carrola1/NFC_Toy/Hardware/Pics/IMG_4041.JPG

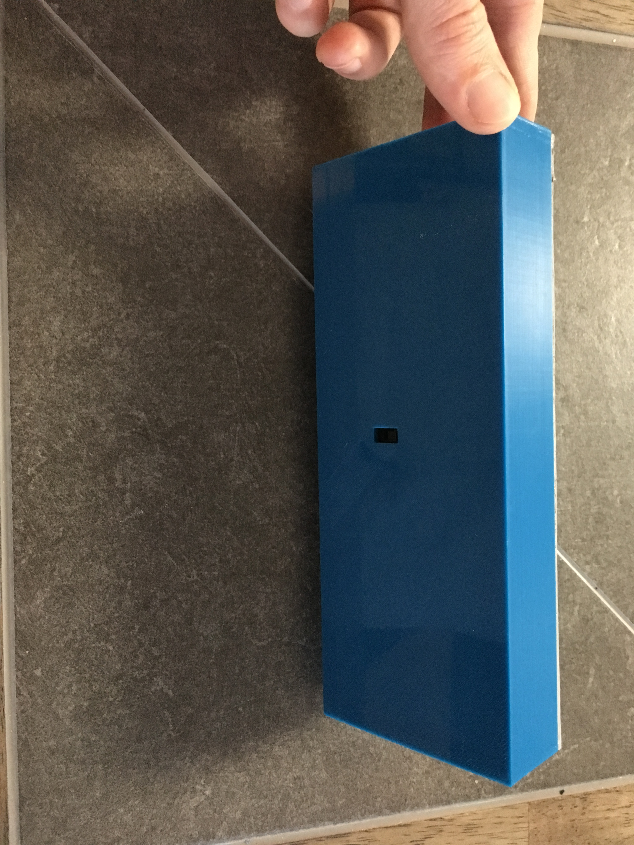
Hardware/Pics/IMG_4041.JPG
