carrola1/NFC_Toy/Hardware/Pics/NFC_TOY.PNG

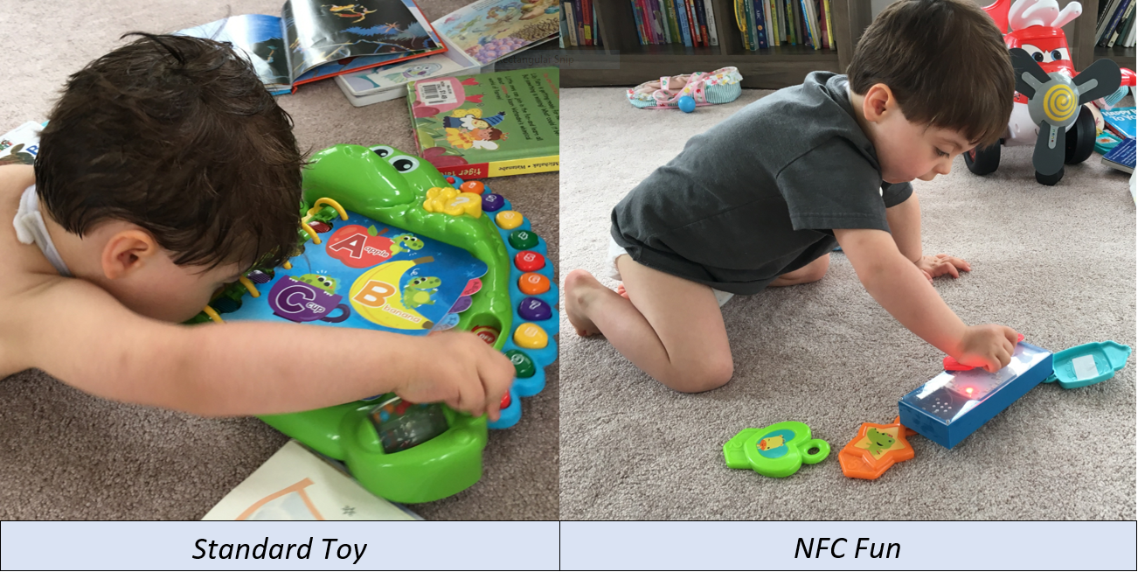
Hardware/Pics/NFC_TOY.PNG
