carrola1/NFC_Toy/Hardware/Adafruit NFC Breakout/Antenna Dimensions.png

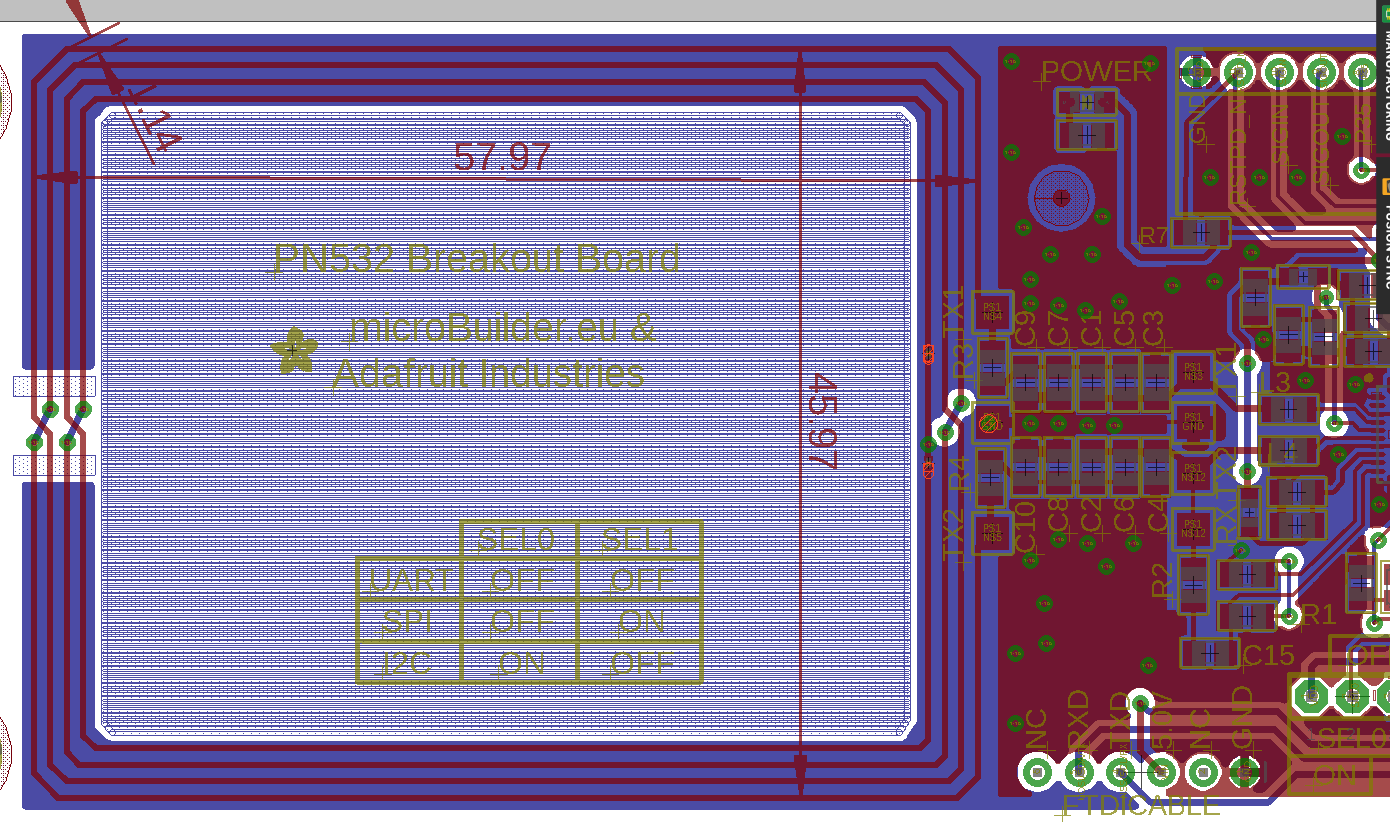
Hardware/Adafruit NFC Breakout/Antenna Dimensions.png
