carrola1/NFC_Toy/Hardware/Pics/IMG_4040.JPG

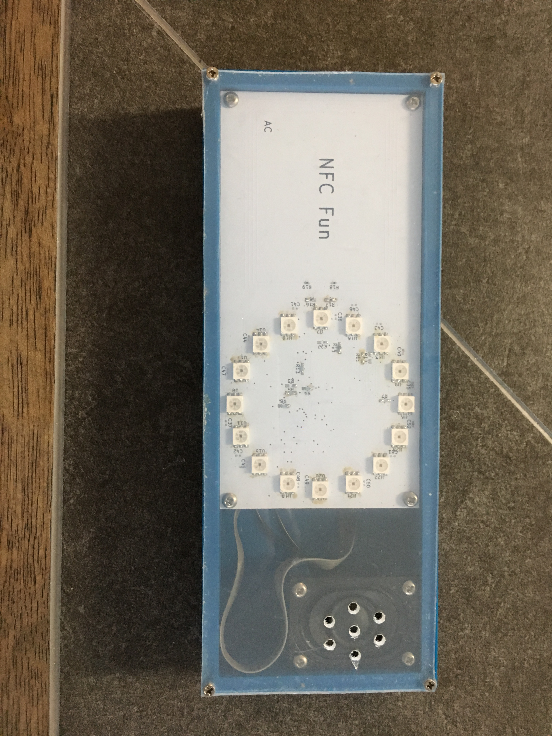
Hardware/Pics/IMG_4040.JPG
