carrola1/NFC_Toy/Hardware/Pics/IMG_4042.JPG

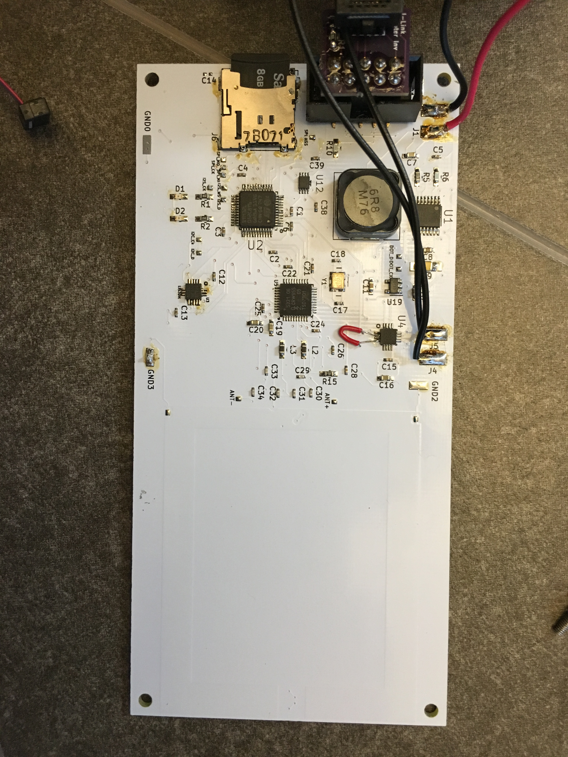
Hardware/Pics/IMG_4042.JPG
