carrola1/NFC_Toy/Hardware/Pics/IMG_4043.JPG

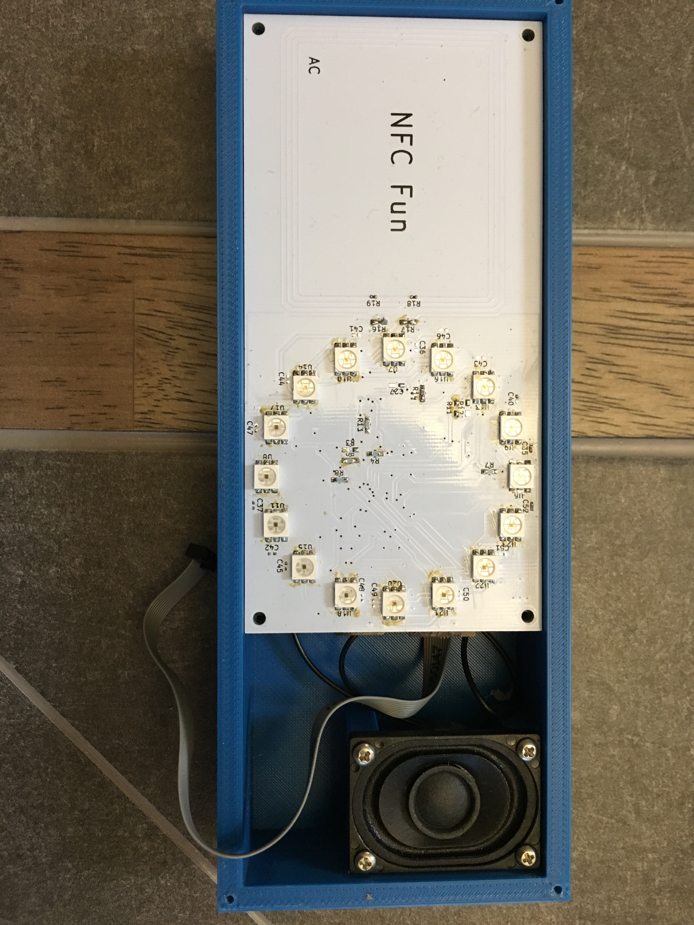
Hardware/Pics/IMG_4043.JPG
