carrola1/NFC_Toy/Hardware/NFC Toy BOM.xlsx

Part # | Manufacturer | Description | Order Qty | Cost | Package | Notes | Footprint Checked | On Order
STM32L052C8T6 | STMicro | Cortex-M0+, 64kB flash, 64kB RAM | 1 | $3.77 | 48-LQFP | 3xSPI/I2S. 1 DAC. | Yes | Yes
MAX98357A | Maxim | I2S Class D audio amp | 1 | $2.22 | 16-TQFN | Arduino library available. This package available on Mouser. | Yes | Yes
PN5321 | NXP | NFC controller | 1 | $11.99 | 40-VFQFN | Widely used. Arduino library available. | Yes | Yes
LIS3DH | STMicro | 3-axis accelerometer | 1 | $1.53 | 16-LGA | Used for space toy. I2C or SPI. | Yes | Yes
5031821852 | Molex | Micro SD connector | 1 | $2.33 | SMD |  | Yes | Yes
TPS61032 | TI | 5V boost converter | 1 | $2.76 | 16-TSSOP | Used on adafruit PowerBoost 1000 | Yes | Yes
MIC5225-3.3 | Microchip | Linear regulator | 1 | $0.41 | SOT-23-5 |  | Yes | Yes
2343 | Adafruit | RGB DotStar LED | 2 | $9.00 | 5x5 mm | Price is for 10 pack | Yes | Yes
3020-10-0300-00 | CNC Tech | SWD header | 1 | $1.29 | SMD | For use with Segger J-Link | Yes | Yes
8.08.91 J-LINK EDU MINI | Segger | J-Link Debugger | 1 | $20.35 | N/A | On digikey or adafruit | N/A | Yes
H3CCH-1006G | Assmann | SWD cable | 1 | $1.10 | N/A | For J-Link | N/A | Yes
LTST-C191KGKT | Lite-On | Green LED, 2V, 20mA | 1 | $0.29 | 0603 |  | N/A | Yes
LTST-C191KFKT | Lite-On | Orange LED, 2V, 20mA | 1 | $0.29 | 0603 |  | N/A | Yes
CDRH124NP-6R8MC | Sumida | Inductor, 6.8uH | 1 | $1.41 | 12x12mm |  | Yes | Yes
7M-27.120MAAJ-T | TXC | 27.12MHz oscillator | 1 | $1.00 | 4-SMD |  | Yes | Yes
SN74LVC2T45 | TI | Dual Level Translator | 1 | $0.61 | 8-VSSOP | For dotstar | Yes | Yes
GCM155R71C104KA55D (https://www.digikey.com/product-detail/en/murata-electronics-north-america/GCM155R71C104KA55D/490-4759-1-ND/1641678) | Murata | Capacitor - 0.1uF | 20 | $0.80 | 0402 |  |  | Yes
GRM188R60J106ME47D (https://www.digikey.com/product-detail/en/murata-electronics-north-america/GRM188R60J106ME47D/490-3896-1-ND/965938) | Murata | Capacitor - 10uF | 10 | $1.20 | 0603 |  |  | Yes
CL10A225KP8NNNC (https://www.digikey.com/product-detail/en/samsung-electro-mechanics/CL10A225KP8NNNC/1276-1085-1-ND/3889171) | Samsung | Capacitor - 2.2uF | 10 | $0.87 | 0603 |  |  | Yes
CC0603ZRY5V6BB105 (https://www.digikey.com/product-detail/en/yageo/CC0603ZRY5V6BB105/311-1357-1-ND/2103141) | Yageo | Capacitor - 1uF | 10 | $0.62 | 0603 |  |  | Yes
F950G227MAAAQ2 (https://www.digikey.com/product-detail/en/avx-corporation/F950G227MAAAQ2/478-8368-1-ND/4005666) |  | Capacitor (Tantalum) - 220uF | 2 | $2.12 | 1206 |  |  | Yes
885012005010 (https://www.digikey.com/product-detail/en/wurth-electronics-inc/885012005010/732-7428-1-ND/5454055) | Wurth | Capacitor - 33pF | 10 | $1.00 | 0402 |  |  | Yes
GRM155R60J102KA01D (https://www.digikey.com/product-detail/en/murata-electronics-north-america/GRM155R60J102KA01D/490-6285-1-ND/3845482) | Murata | Capacitor - 1000pF | 10 | $0.30 | 0402 |  |  | Yes
885012005015 | Wurth | Capacitor - 220pF | 10 | $1.00 | 0402 |  |  | Yes
885012005009 | Wurth | Capacitor - 22pF | 10 | $1.00 | 0402 |  |  | Yes
885012005013 | Wurth | Capacitor - 100pF | 10 | $1.00 | 0402 |  |  | Yes
MLJ1608WR56JT000 (https://www.digikey.com/product-detail/en/tdk-corporation/MLJ1608WR56JT000/445-174193-1-ND/5813302) | TDK | Inductor - 560 nH | 4 | $1.20 | 0603 |  |  | Yes
RMCF0603FT121R (https://www.digikey.com/product-detail/en/stackpole-electronics-inc/RMCF0603FT121R/RMCF0603FT121RCT-ND/1942968) | Stackpole | Resistor - 121 ohm | 10 | $0.15 | 0603 |  |  | Yes
MCT06030C1002FP500 (https://www.digikey.com/product-detail/en/vishay-beyschlag/MCT06030C1002FP500/MCT0603-10.0K-CFCT-ND/2607933) | Yageo | Resistor - 10k ohm | 20 | $0.30 | 0603 |  |  | Yes
RC0603FR-0730KL | Yageo | Resistor - 30k ohm | 10 | $0.15 | 0603 |  |  | Yes
RC0603FR-071KL (https://www.digikey.com/product-detail/en/yageo/RC0603FR-071KL/311-1.00KHRCT-ND/729790) | Yageo | Resistor - 1k ohm | 10 | $0.15 | 0603 |  |  | Yes
RC0603FR-071K5L (https://www.digikey.com/product-detail/en/yageo/RC0603FR-071K5L/311-1.50KHRCT-ND/729811) | Yageo | Resistor - 1.5k ohm | 10 | $0.15 | 0603 |  |  | Yes
RC0603FR-071K6L (https://www.digikey.com/product-detail/en/yageo/RC0603FR-071K6L/311-1.60KHRCT-ND/729815) | Yageo | Resistor - 1.6k ohm | 10 | $0.15 | 0603 |  |  | Yes
RR0816P-104-D (https://www.digikey.com/product-detail/en/susumu/RR0816P-104-D/RR08P100KDCT-ND/432772) | Susumu | Resistor - 100k ohm | 10 | $0.98 | 0603 |  |  | Yes
RC1005J000CS (https://www.digikey.com/product-detail/en/samsung-electro-mechanics/RC1005J000CS/1276-3480-1-ND/3903583) | Samsung | Resistor - 0 ohm | 10 |  | 0402 |  |  | Yes
SFH11-PBPC-D05-ST-BK (https://www.digikey.com/product-detail/en/sullins-connector-solutions/SFH11-PBPC-D05-ST-BK/S9194-ND/1990087) |  | 10-pin plug - 0.1" | 1 | $0.66 | Through Hole
20021121-00010C4LF (https://www.digikey.com/product-detail/en/amphenol-fci/20021121-00010C4LF/609-3695-1-ND/2209147) | Amphenol | 10-pin header - .005" | 1 | $0.84 | SMT
 |  |  | Total | $73.49
