carrola1/NFC_Toy/Hardware/Enclosure/NFC Toy Base.stl

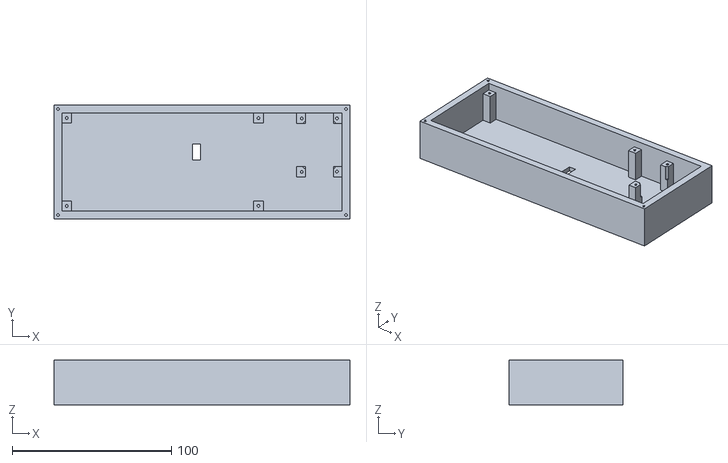
[picture p7: CAD file, 2019-02-22]
Hardware/Enclosure/NFC Toy Base.stl
186.0 x 71.6 x 28.0
