carrola1/NFC_Toy/(list of files, cad)

Other CAD files:
Hardware/Enclosure/NFC Toy Base (old).stl
