carrola1/NFC_Toy/Hardware/NFC_Toy_KiCAD/JLink_Adpater/JLink_Adpater.kicad_pcb

## KiCad design Hardware/NFC_Toy_KiCAD/JLink_Adpater/JLink_Adpater.kicad_pcb (2018-05-30)

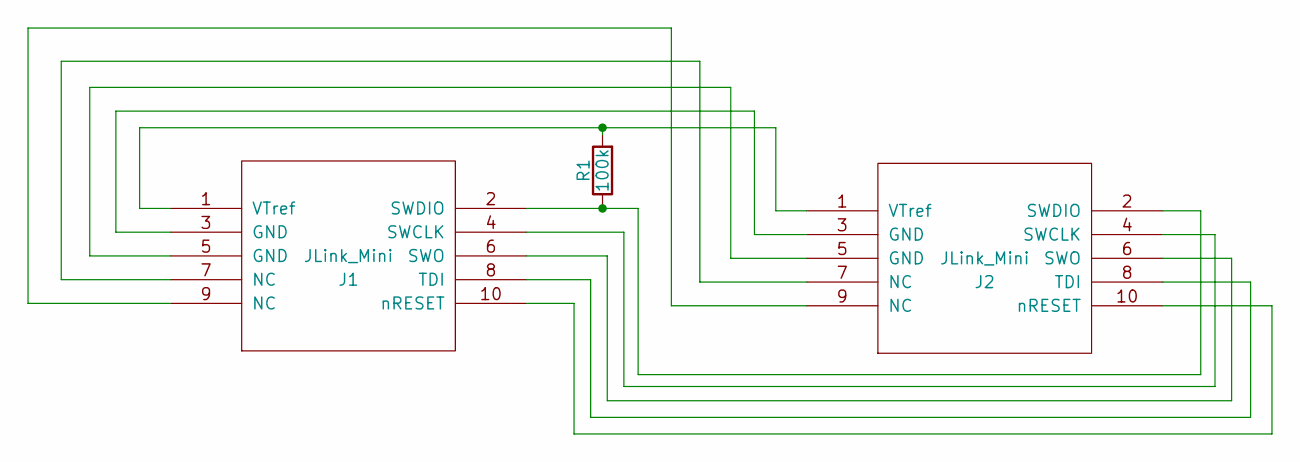
[picture p8: schematic JLink_Adpater.sch]

Parts:
J1: JLink_Mini; JLink_Mini_0p05_inverted
J2: JLink_Mini; J-Link_0p1in_inverted
R1: 100k; R_0603_HandSoldering

Connections:
unnamed: J1.1 (VTref), J2.1 (VTref), R1.2
unnamed: J1.2 (SWDIO), J2.2 (SWDIO), R1.1
unnamed: J1.3 (GND), J2.3 (GND)
unnamed: J1.4 (SWCLK), J2.4 (SWCLK)
unnamed: J1.5 (GND), J2.5 (GND)
unnamed: J1.6 (SWO), J2.6 (SWO)
unnamed: J1.7 (NC), J2.7 (NC)
unnamed: J1.8 (TDI), J2.8 (TDI)
unnamed: J1.9 (NC), J2.9 (NC)
unnamed: J1.10 (nRESET), J2.10 (nRESET)

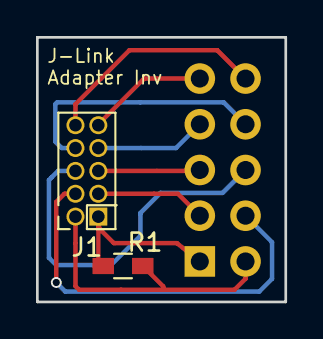
[picture p9: board JLink_Adpater.kicad_pcb from above]

Board: 2 copper layers, 13.8 x 14.7 mm, 3 parts (1 on the bottom side), 10 nets.
