carrola1/NFC_Toy/Hardware/NFC_Toy_KiCAD/NFC_Toy.kicad_pcb

## KiCad design Hardware/NFC_Toy_KiCAD/NFC_Toy.kicad_pcb (2018-05-02)

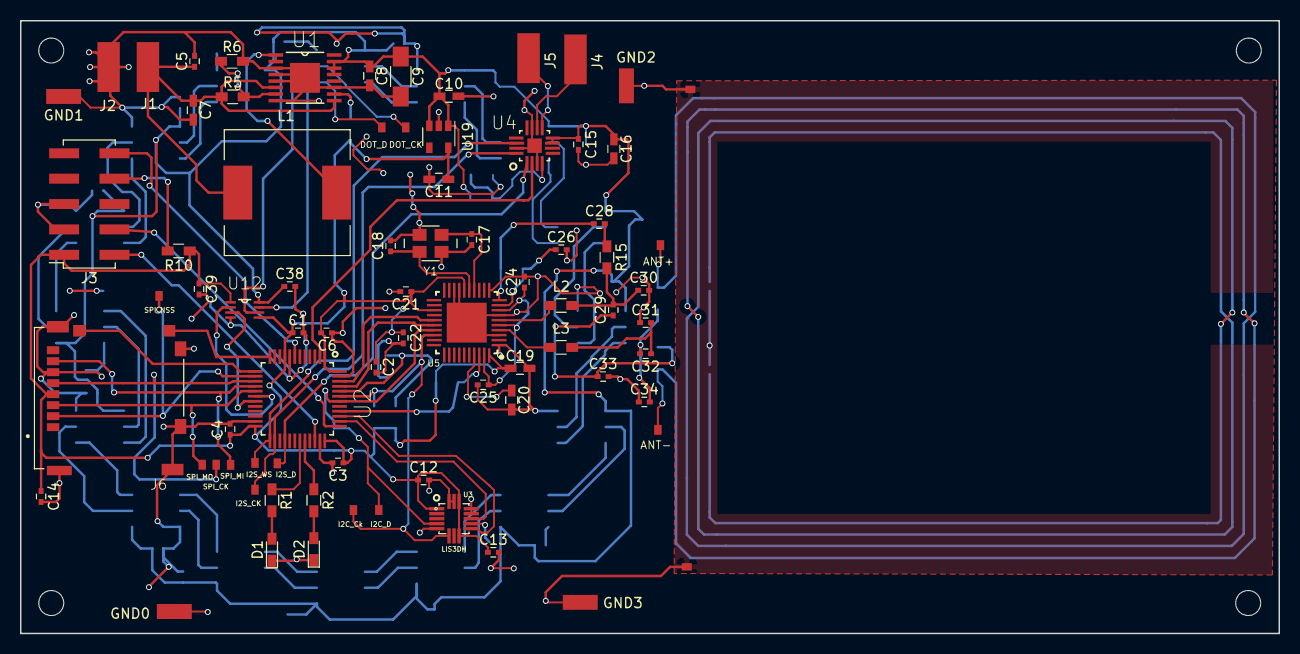
[picture p10: board NFC_Toy.kicad_pcb from above]

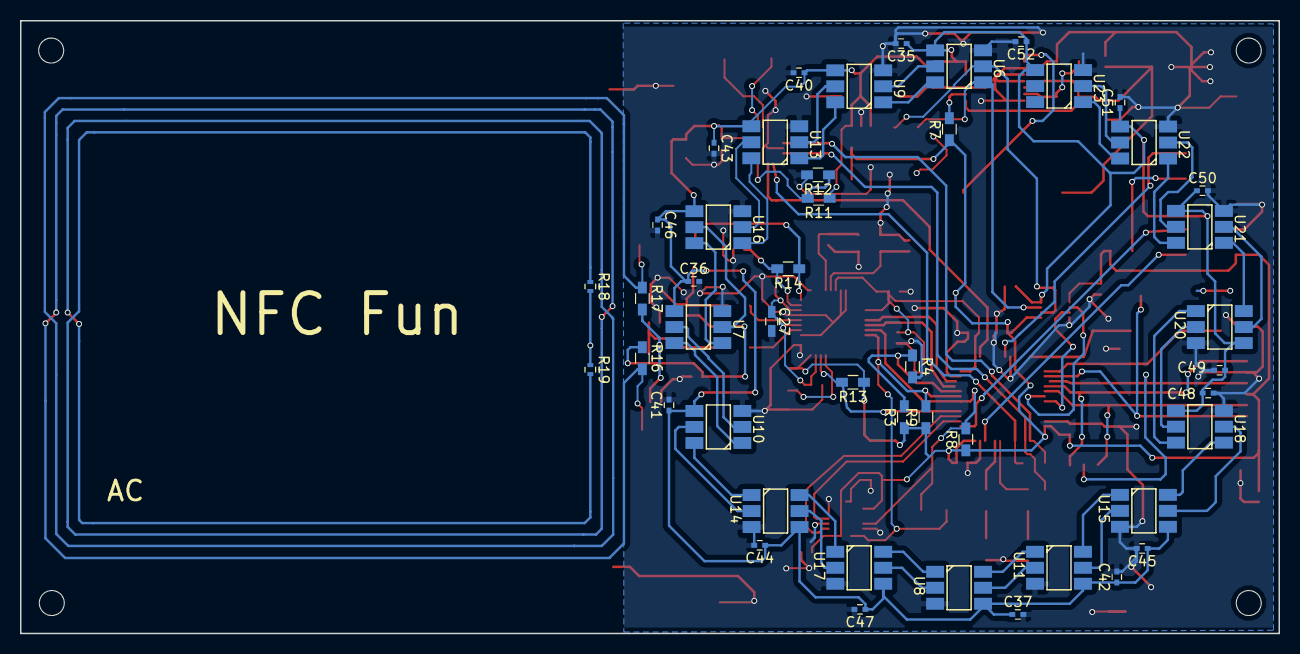
[picture p11: board NFC_Toy.kicad_pcb from below]

Board: 2 copper layers, 126.0 x 61.3 mm, 128 parts (46 on the bottom side), 85 nets.

Parts:
ANT+: TEST; Test_Point
ANT-: TEST; Test_Point
C1, C2, C3, C4, C5, C6, C12, C13, C14, C15, C21, C22, C24, C25, C26, C35, C36, C37, C38, C39, C40, C41, C42, C43, C44, C45, C46, C47, C48, C49, C50, C51, C52: 0.1u; C_0402
C7, C16, C19, C20, C27: 10u; C_0603_HandSoldering
C8, C11: 2.2u; C_0603_HandSoldering
C9: 220u; C_1206_HandSoldering
C10: 1u; C_0603_HandSoldering
C17, C18: 33p; C_0402
C28: 1000p; C_0402
C29, C32: 22p; C_0402
C30, C31: 220p; C_0402
C33, C34: 100p; C_0402
D1, D2: LED; LED_0603_HandSoldering
DOT_CK: TEST; Test_Point
DOT_D: TEST; Test_Point
GND0, GND1, GND2, GND3, GND4, GND4#2: TEST; Test_Point
I2C_Ck, I2C_D, I2S_CK, I2S_D, I2S_WS: TEST; Test_Point
J1, J2: Pad; Pad_SMD_Small
J3: JLink_Mini; Socket_Strip_Straight_2x05_Pitch2.54mm_SMD
J4: SPKR-; Pad_SMD_Small
J5: SPKR+; Pad_SMD_Small
J6: 503182-1852; MOLEX_503182-1852
L1: 6.8u; L_12x12mm_h4.5mm
L2, L3: 560n; L_0603_HandSoldering
MK1, MK2, MK3, MK4: Mounting_Hole; MountingHole_2.5mm
R1, R2: 121; R_0603_HandSoldering
R3, R11, R12: DNP; R_0603_HandSoldering
R4, R6, R7, R8, R9, R10, R13: 10k; R_0603_HandSoldering
R5: 30k; R_0603_HandSoldering
R14: 1k; R_0603_HandSoldering
R15: 1.6k; R_0603_HandSoldering
R16, R17: 1.5; R_0603_HandSoldering
R18, R19: 0; R_0402
SPI_CK: TEST; Test_Point
SPI_MI: TEST; Test_Point
SPI_MO: TEST; Test_Point
SPI_NSS: TEST; Test_Point
U1: TPS61032; SOP65P640X120-17N
U2: STM32L0-LQFP48; QFP50P900X900X160-48N
U3: LIS3DH; LGA16R50P5X3_300X300X100N
U4: MAX98357; QFN50P300X300X80-17N
U5: PN532; HVQFN40-6X6
U6, U7, U8, U9, U10, U11, U13, U14, U15, U16, U17, U18, U20, U21, U22, U23: APA102; APA102_hand_solder
U12: SN74LVC2T45; SOP50P310X90-8N
U19: MIC5225; SOT-23-5
Y1: Oscillator; OSCCC500X320X105N

Connections:
+3V3: C1.1, C2.1, C3.1, C4.1, C6.1, C11.1, C12.1, C13.1, C14.1, C19.1, C21.1, C22.1, C39.1, J3.1, J6.4, R3.1, R7.1, R8.1, R9.1, R10.1, R13.1, U2.1, U2.9, U2.24, U2.36, U2.48, U3.1, U3.8, U3.14, U5.16, U5.23, U5.40, U12.1, U12.5, U19.5
+5V: C8.1, C9.1, C10.1, C15.1, C16.1, C35.1, C36.1, C37.1, C38.1, C40.1, C41.1, C42.1, C43.1, C44.1, C45.1, C46.1, C47.1, C48.1, C49.1, C50.1, C51.1, C52.1, R11.1, U1.13, U1.14, U1.15, U4.7, U4.8, U6.4, U7.4, U8.4, U9.4, U10.4, U11.4, U12.8, U13.4, U14.4, U15.4, U16.4, U17.4, U18.4, U19.1, U19.3, U20.4, U21.4, U22.4, U23.4
+BATT: C5.1, C7.1, J1.1, L1.1, R5.1, U1.6, U1.9
AUDIO_SD_N: U2.2, U4.2
DotStar_CO_0: U7.2, U16.5
DotStar_CO_1: U8.2, U17.5
DotStar_CO_2: U18.5, U20.2
DotStar_Clk_3V: U2.19, U12.3
DotStar_Clk_5V: DOT_CK.1, U6.2, U12.6
DotStar_DO_0: U7.1, U16.6
DotStar_DO_1: U8.1, U17.6
DotStar_DO_2: U18.6, U20.1
DotStar_Data_3V: U2.18, U12.2
DotStar_Data_5V: DOT_D.1, U6.1, U12.7
GND: C1.2, C2.2, C3.2, C4.2, C5.2, C6.2, C7.2, C8.2, C9.2, C10.2, C11.2, C12.2, C13.2, C14.2, C15.2, C16.2, C17.2, C18.2, C19.2, C20.2, C21.2, C22.2, C24.2, C25.2, C26.2, C27.2, C30.2, C31.1, C33.2, C34.1, C35.2, C36.2, C37.2, C38.2, C39.2, C40.2, C41.2, C42.2, C43.2, C44.2, C45.2, C46.2, C47.2, C48.2, C49.2, C50.2, C51.2, C52.2, D1.1, D2.1, GND0.1, GND1.1, GND2.1, GND3.1, GND4.1, GND4#2.1, J2.1, J3.3, J3.5, J6.6, J6.P1, J6.P2, J6.P3, J6.P4, J6.P5, R4.2, R6.2, R12.2, R18.2, R19.1, U1.3, U1.4, U1.5, U1.8, U1.11, U1.17, U2.8, U2.23, U2.35, U2.47, U3.5, U3.10, U3.12, U3.13, U3.15, U3.16, U4.3, U4.11, U4.15, U4.17, U5.1, U5.3, U5.7, U5.11, U5.17, U5.18, U5.TP, U6.3, U7.3, U8.3, U9.3, U10.3, U11.3, U12.4, U13.3, U14.3, U15.3, U16.3, U17.3, U18.3, U19.2, U20.3, U21.3, U22.3, U23.3, Y1.2, Y1.4
I2C_SCL: I2C_D.1, R8.2, U2.42, U3.4, U5.27
I2C_SDA: I2C_Ck.1, R9.2, U2.43, U3.6, U5.28
I2S_CK: I2S_CK.1, U2.26, U4.16
I2S_SD: I2S_D.1, U2.28, U4.1
I2S_WS: I2S_WS.1, U2.25, U4.14
NFC_IRQ: U2.46, U5.25
NFC_RST_N: U2.45, U5.26
NFC_RST_PDN_N: R13.2, U2.40, U5.38
unnamed: C17.1, U5.14, Y1.1
unnamed: C18.1, U5.15, Y1.3
unnamed: C20.1, U5.37
unnamed: C26.1, R14.2, U5.9
unnamed: C28.1, R14.1, U5.10
unnamed: C28.2, R15.1
unnamed: C29.1, C33.1, R16.1
unnamed: C29.2, C30.1, L2.2, R15.2
unnamed: C31.2, C32.1, L3.2
unnamed: C32.2, C34.2, R17.2
unnamed: D1.2, R1.2
unnamed: D2.2, R2.2
unnamed: J3.8, R10.2
unnamed: J4.1, U4.10
unnamed: J5.1, U4.9
unnamed: L1.2, U1.1, U1.2
unnamed: L2.1, U5.6
unnamed: L3.1, U5.4
unnamed: R1.1, U2.31
unnamed: R2.1, U2.32
unnamed: R3.2, R4.1, U2.44
unnamed: R5.2, R6.1, U1.7
unnamed: R7.2, U1.10
unnamed: R11.2, R12.1, U4.4
unnamed: ANT-.1, R16.2, R18.1
unnamed: ANT+.1, R17.1, R19.2
unnamed: U6.5, U9.2
unnamed: U6.6, U9.1
unnamed: U7.6, U10.1
unnamed: U7.5, U10.2
unnamed: U10.5, U14.2
unnamed: U10.6, U14.1
unnamed: U8.6, U11.1
unnamed: U8.5, U11.2
unnamed: U11.5, U15.2
unnamed: U11.6, U15.1
unnamed: U9.6, U13.1
unnamed: U9.5, U13.2
unnamed: U13.5, U16.2
unnamed: U13.6, U16.1
unnamed: U14.5, U17.2
unnamed: U14.6, U17.1
unnamed: U15.5, U18.2
unnamed: U15.6, U18.1
unnamed: U20.5, U21.2
unnamed: U20.6, U21.1
unnamed: U21.5, U22.2
unnamed: U21.6, U22.1
unnamed: U22.5, U23.2
unnamed: U22.6, U23.1
SD_DETECT: J6.DT, U2.12
SD_SW: J6.SW, U2.13
SPI_MISO: J6.7, SPI_MI.1, U2.16
SPI_MOSI: J6.3, SPI_MO.1, U2.17
SPI_NSS: J6.2, SPI_NSS.1, U2.14
SPI_SCK: J6.5, SPI_CK.1, U2.15
SWCLK: J3.4, U2.37
SWDIO: J3.2, U2.34
VCC: C24.1, C25.1, C27.1, U5.5, U5.8, U5.39
XL_INT1: U2.38, U3.11
XL_INT2: U2.39, U3.9
nRST: J3.10, U2.7
