carrola1/NFC_Toy/Hardware/NFC_Toy_KiCAD/NFC_Toy.sch

## KiCad design Hardware/NFC_Toy_KiCAD/NFC_Toy.sch (2019-06-26, an earlier design)

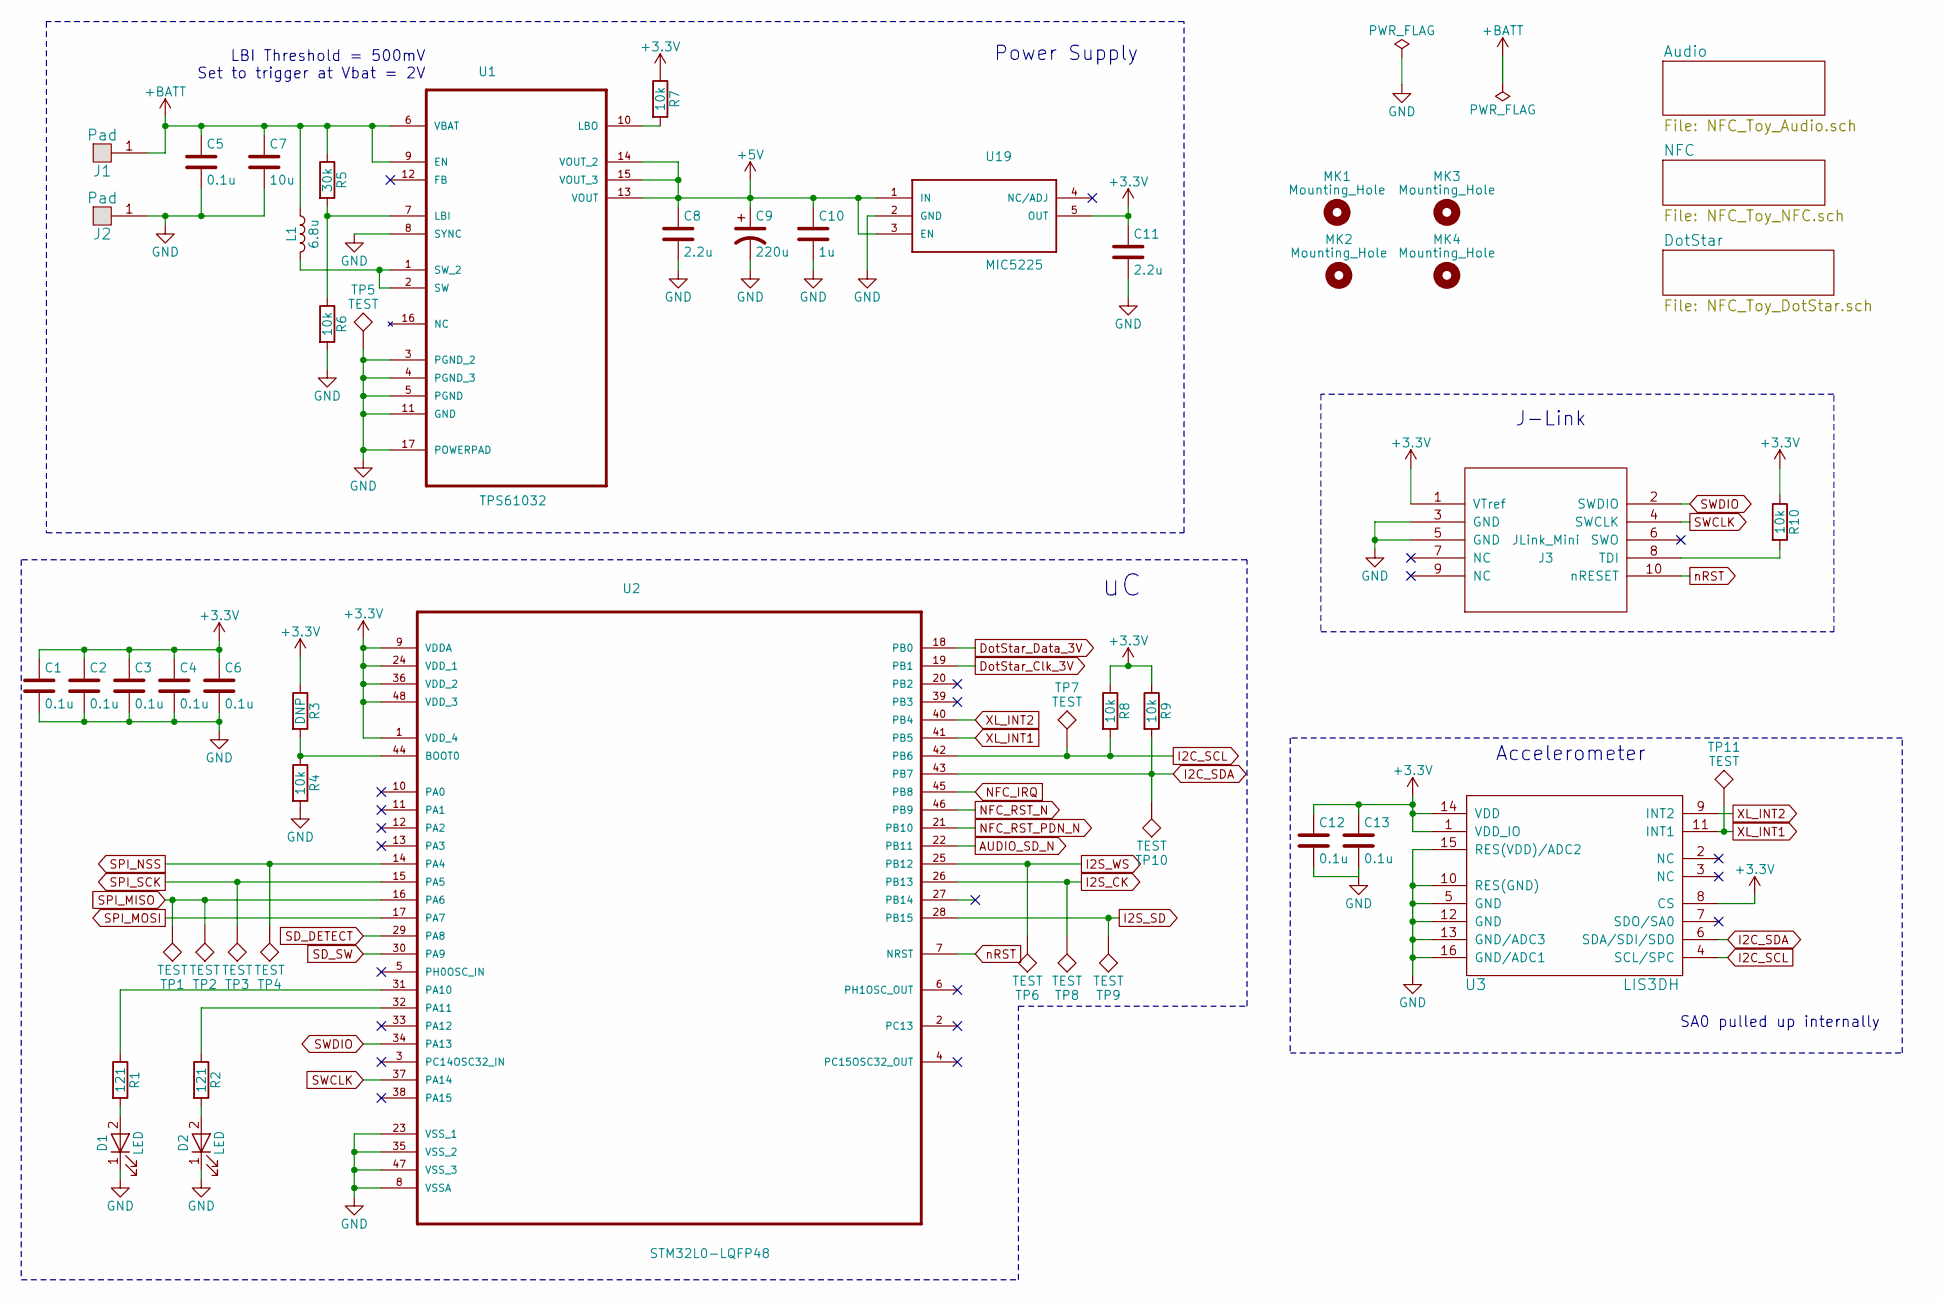
[picture p12: schematic NFC_Toy.sch]

Parts:
C1, C2, C3, C4, C5, C6, C12, C13: 0.1u; C_0402
C7: 10u; C_0603_HandSoldering
C8, C11: 2.2u; C_0603_HandSoldering
C9: 220u; C_1206_HandSoldering
C10: 1u; C_0603_HandSoldering
D1, D2: LED; LED_0603_HandSoldering
J1, J2: Pad; Pad_SMD_Small
J3: JLink_Mini; Socket_Strip_Straight_2x05_Pitch2.54mm_SMD
L1: 6.8u; L_12x12mm_h4.5mm
MK1, MK2, MK3, MK4: Mounting_Hole; MountingHole_2.5mm
R1, R2: 121; R_0603_HandSoldering
R3: DNP; R_0603_HandSoldering
R4, R6, R7, R8, R9, R10: 10k; R_0603_HandSoldering
R5: 30k; R_0603_HandSoldering
TP1, TP2, TP3, TP4, TP5, TP6, TP7, TP8, TP9, TP10, TP11: TEST; Test_Point
U1: TPS61032; SOP65P640X120-17N
U2: STM32L0-LQFP48; QFP50P900X900X160-48N
U3: LIS3DH; LGA16R50P5X3_300X300X100N
U19: MIC5225; SOT-23-5

Connections:
+3.3V: C1.1, C2.1, C3.1, C4.1, C6.1, C11.1, C12.1, C13.1, J3.1 (VTref), R3.1, R7.1, R8.1, R9.1, R10.1, U2.1 (VDD_4), U2.9 (VDDA), U2.24 (VDD_1), U2.36 (VDD_2), U2.48 (VDD_3), U3.1 (VDD_IO), U3.8 (CS), U3.14 (VDD), U19.5 (OUT)
+5V: C8.1, C9.1, C10.1, U1.13 (VOUT), U1.14 (VOUT_2), U1.15 (VOUT_3), U19.1 (IN), U19.3 (EN)
+BATT: C5.1, C7.1, J1.1, L1.1, R5.1, U1.6 (VBAT), U1.9 (EN)
AUDIO_SD_N: U2.22 (PB11)
DotStar_Clk_3V: U2.19 (PB1)
DotStar_Data_3V: U2.18 (PB0)
GND: C1.2, C2.2, C3.2, C4.2, C5.2, C6.2, C7.2, C8.2, C9.2, C10.2, C11.2, C12.2, C13.2, D1.1 (K), D2.1 (K), J2.1, J3.3 (GND), J3.5 (GND), R4.2, R6.2, TP5.1, U1.3 (PGND_2), U1.4 (PGND_3), U1.5 (PGND), U1.8 (SYNC), U1.11 (GND), U1.17 (POWERPAD), U2.8 (VSSA), U2.23 (VSS_1), U2.35 (VSS_2), U2.47 (VSS_3), U3.5 (GND), U3.10 (RES(GND)), U3.12 (GND), U3.13 (GND/ADC3), U3.15 (RES(VDD)/ADC2), U3.16 (GND/ADC1), U19.2 (GND)
I2C_SCL: R8.2, TP7.1, U2.42 (PB6), U3.4 (SCL/SPC)
I2C_SDA: R9.2, TP10.1, U2.43 (PB7), U3.6 (SDA/SDI/SDO)
I2S_CK: TP8.1, U2.26 (PB13)
I2S_SD: TP9.1, U2.28 (PB15)
I2S_WS: TP6.1, U2.25 (PB12)
NFC_IRQ: U2.45 (PB8)
NFC_RST_N: U2.46 (PB9)
NFC_RST_PDN_N: U2.21 (PB10)
unnamed: D1.2 (A), R1.2
unnamed: D2.2 (A), R2.2
unnamed: J3.8 (TDI), R10.2
unnamed: L1.2, U1.1 (SW_2), U1.2 (SW)
unnamed: R1.1, U2.31 (PA10)
unnamed: R2.1, U2.32 (PA11)
unnamed: R3.2, R4.1, U2.44 (BOOT0)
unnamed: R5.2, R6.1, U1.7 (LBI)
unnamed: R7.2, U1.10 (LBO)
SD_DETECT: U2.29 (PA8)
SD_SW: U2.30 (PA9)
SPI_MISO: TP1.1, TP2.1, U2.16 (PA6)
SPI_MOSI: U2.17 (PA7)
SPI_NSS: TP4.1, U2.14 (PA4)
SPI_SCK: TP3.1, U2.15 (PA5)
SWCLK: J3.4 (SWCLK), U2.37 (PA14)
SWDIO: J3.2 (SWDIO), U2.34 (PA13)
XL_INT1: TP11.1, U2.41 (PB5), U3.11 (INT1)
XL_INT2: U2.40 (PB4), U3.9 (INT2)
nRST: J3.10 (nRESET), U2.7 (NRST)

Notes on the sheet:
LBI Threshold = 500mV Set to trigger at Vbat = 2V
SA0 pulled up internally
Power Supply
J-Link
Accelerometer
