carrola1/NFC_Toy/Hardware/NFC_Toy_KiCAD/NFC_Toy_Audio.sch

## KiCad design Hardware/NFC_Toy_KiCAD/NFC_Toy_Audio.sch (2019-06-26, an earlier design)

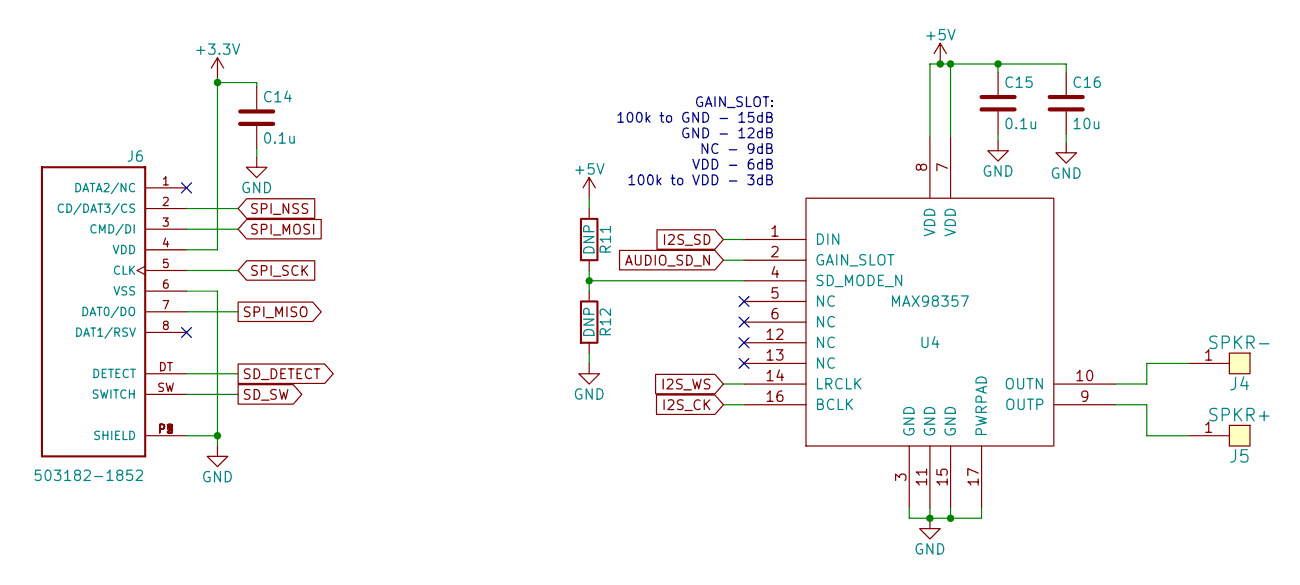
[picture p13: schematic NFC_Toy_Audio.sch]

Parts:
C14, C15: 0.1u; C_0402
C16: 10u; C_0603_HandSoldering
J4: SPKR-; Pad_SMD_Small
J5: SPKR+; Pad_SMD_Small
J6: 503182-1852; MOLEX_503182-1852
R11, R12: DNP; R_0603_HandSoldering
U4: MAX98357; QFN50P300X300X80-17N

Connections:
+3.3V: C14.1, J6.4 (VDD)
+5V: C15.1, C16.1, R11.1, U4.7 (VDD), U4.8 (VDD)
AUDIO_SD_N: U4.2 (GAIN_SLOT)
GND: C14.2, C15.2, C16.2, J6.6 (VSS), J6.P1 (SHIELD), J6.P2 (SHIELD), J6.P3 (SHIELD), J6.P4 (SHIELD), J6.P5 (SHIELD), R12.2, U4.3 (GND), U4.11 (GND), U4.15 (GND), U4.17 (PWRPAD)
I2S_CK: U4.16 (BCLK)
I2S_SD: U4.1 (DIN)
I2S_WS: U4.14 (LRCLK)
unnamed: J4.1, U4.10 (OUTN)
unnamed: J5.1, U4.9 (OUTP)
unnamed: R11.2, R12.1, U4.4 (SD_MODE_N)
SD_DETECT: J6.DT (DETECT)
SD_SW: J6.SW (SWITCH)
SPI_MISO: J6.7 (DAT0/DO)
SPI_MOSI: J6.3 (CMD/DI)
SPI_NSS: J6.2 (CD/DAT3/CS)
SPI_SCK: J6.5 (CLK)

Notes on the sheet:
GAIN_SLOT: 100k to GND - 15dB GND - 12dB NC - 9dB VDD - 6dB 100k to VDD - 3dB
