carrola1/NFC_Toy/Hardware/NFC_Toy_KiCAD/NFC_Toy_DotStar.sch

## KiCad design Hardware/NFC_Toy_KiCAD/NFC_Toy_DotStar.sch (2019-06-26, an earlier design)

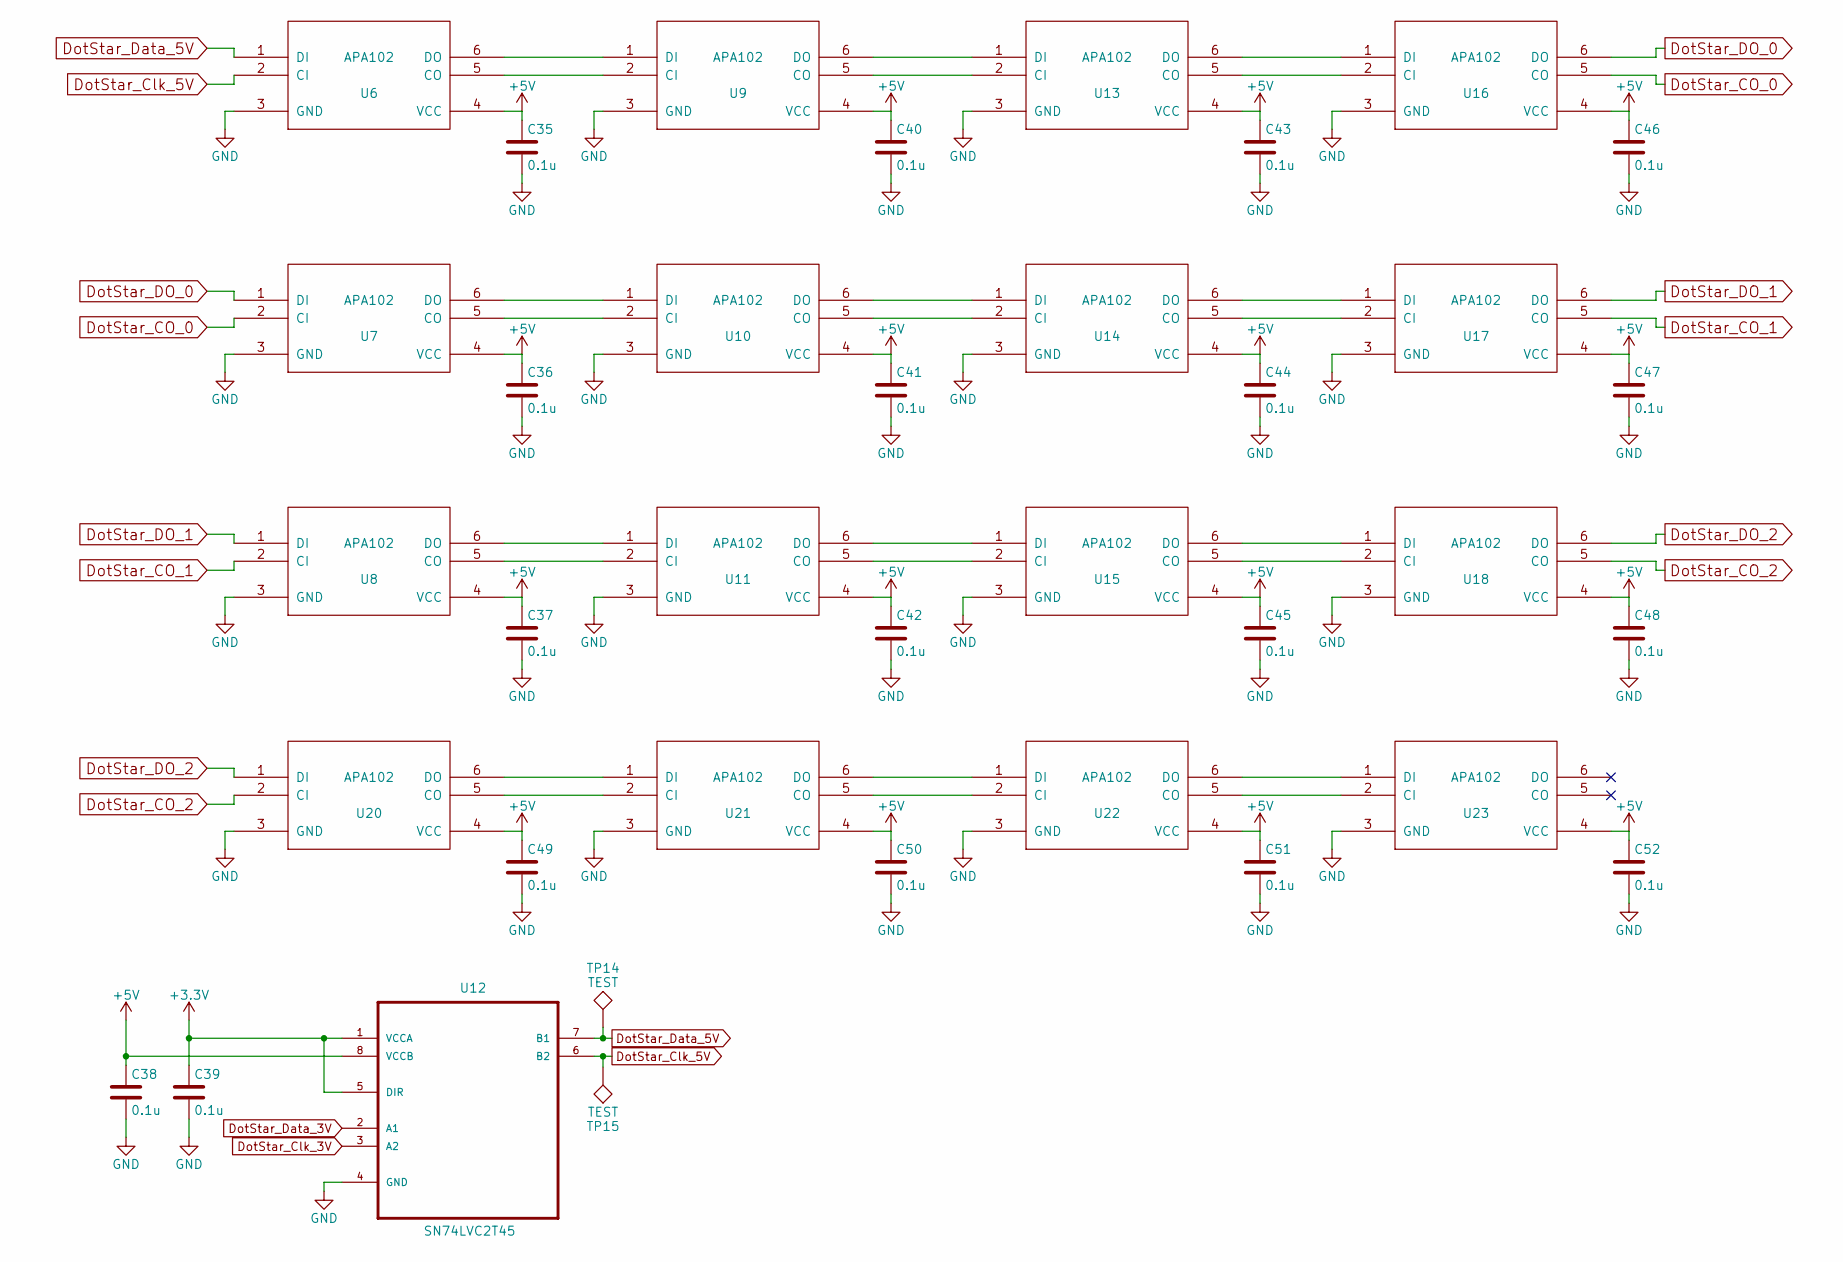
[picture p14: schematic NFC_Toy_DotStar.sch]

Parts:
C35, C36, C37, C38, C39, C40, C41, C42, C43, C44, C45, C46, C47, C48, C49, C50, C51, C52: 0.1u; C_0402
TP14, TP15: TEST; Test_Point
U6, U7, U8, U9, U10, U11, U13, U14, U15, U16, U17, U18, U20, U21, U22, U23: APA102; APA102_hand_solder
U12: SN74LVC2T45; SOP50P310X90-8N

Connections:
+3.3V: C39.1, U12.1 (VCCA), U12.5 (DIR)
+5V: C35.1, C36.1, C37.1, C38.1, C40.1, C41.1, C42.1, C43.1, C44.1, C45.1, C46.1, C47.1, C48.1, C49.1, C50.1, C51.1, C52.1, U6.4 (VCC), U7.4 (VCC), U8.4 (VCC), U9.4 (VCC), U10.4 (VCC), U11.4 (VCC), U12.8 (VCCB), U13.4 (VCC), U14.4 (VCC), U15.4 (VCC), U16.4 (VCC), U17.4 (VCC), U18.4 (VCC), U20.4 (VCC), U21.4 (VCC), U22.4 (VCC), U23.4 (VCC)
DotStar_CO_0: U7.2 (CI), U16.5 (CO)
DotStar_CO_1: U8.2 (CI), U17.5 (CO)
DotStar_CO_2: U18.5 (CO), U20.2 (CI)
DotStar_Clk_3V: U12.3 (A2)
DotStar_Clk_5V: TP15.1, U6.2 (CI), U12.6 (B2)
DotStar_DO_0: U7.1 (DI), U16.6 (DO)
DotStar_DO_1: U8.1 (DI), U17.6 (DO)
DotStar_DO_2: U18.6 (DO), U20.1 (DI)
DotStar_Data_3V: U12.2 (A1)
DotStar_Data_5V: TP14.1, U6.1 (DI), U12.7 (B1)
GND: C35.2, C36.2, C37.2, C38.2, C39.2, C40.2, C41.2, C42.2, C43.2, C44.2, C45.2, C46.2, C47.2, C48.2, C49.2, C50.2, C51.2, C52.2, U6.3 (GND), U7.3 (GND), U8.3 (GND), U9.3 (GND), U10.3 (GND), U11.3 (GND), U12.4 (GND), U13.3 (GND), U14.3 (GND), U15.3 (GND), U16.3 (GND), U17.3 (GND), U18.3 (GND), U20.3 (GND), U21.3 (GND), U22.3 (GND), U23.3 (GND)
unnamed: U6.5 (CO), U9.2 (CI)
unnamed: U6.6 (DO), U9.1 (DI)
unnamed: U7.6 (DO), U10.1 (DI)
unnamed: U7.5 (CO), U10.2 (CI)
unnamed: U10.5 (CO), U14.2 (CI)
unnamed: U10.6 (DO), U14.1 (DI)
unnamed: U8.6 (DO), U11.1 (DI)
unnamed: U8.5 (CO), U11.2 (CI)
unnamed: U11.5 (CO), U15.2 (CI)
unnamed: U11.6 (DO), U15.1 (DI)
unnamed: U9.6 (DO), U13.1 (DI)
unnamed: U9.5 (CO), U13.2 (CI)
unnamed: U13.5 (CO), U16.2 (CI)
unnamed: U13.6 (DO), U16.1 (DI)
unnamed: U14.5 (CO), U17.2 (CI)
unnamed: U14.6 (DO), U17.1 (DI)
unnamed: U15.5 (CO), U18.2 (CI)
unnamed: U15.6 (DO), U18.1 (DI)
unnamed: U20.5 (CO), U21.2 (CI)
unnamed: U20.6 (DO), U21.1 (DI)
unnamed: U21.5 (CO), U22.2 (CI)
unnamed: U21.6 (DO), U22.1 (DI)
unnamed: U22.5 (CO), U23.2 (CI)
unnamed: U22.6 (DO), U23.1 (DI)
