carrola1/NFC_Toy/Hardware/NFC_Toy_KiCAD/NFC_Toy_NFC.sch

## KiCad design Hardware/NFC_Toy_KiCAD/NFC_Toy_NFC.sch (2019-06-26, an earlier design)

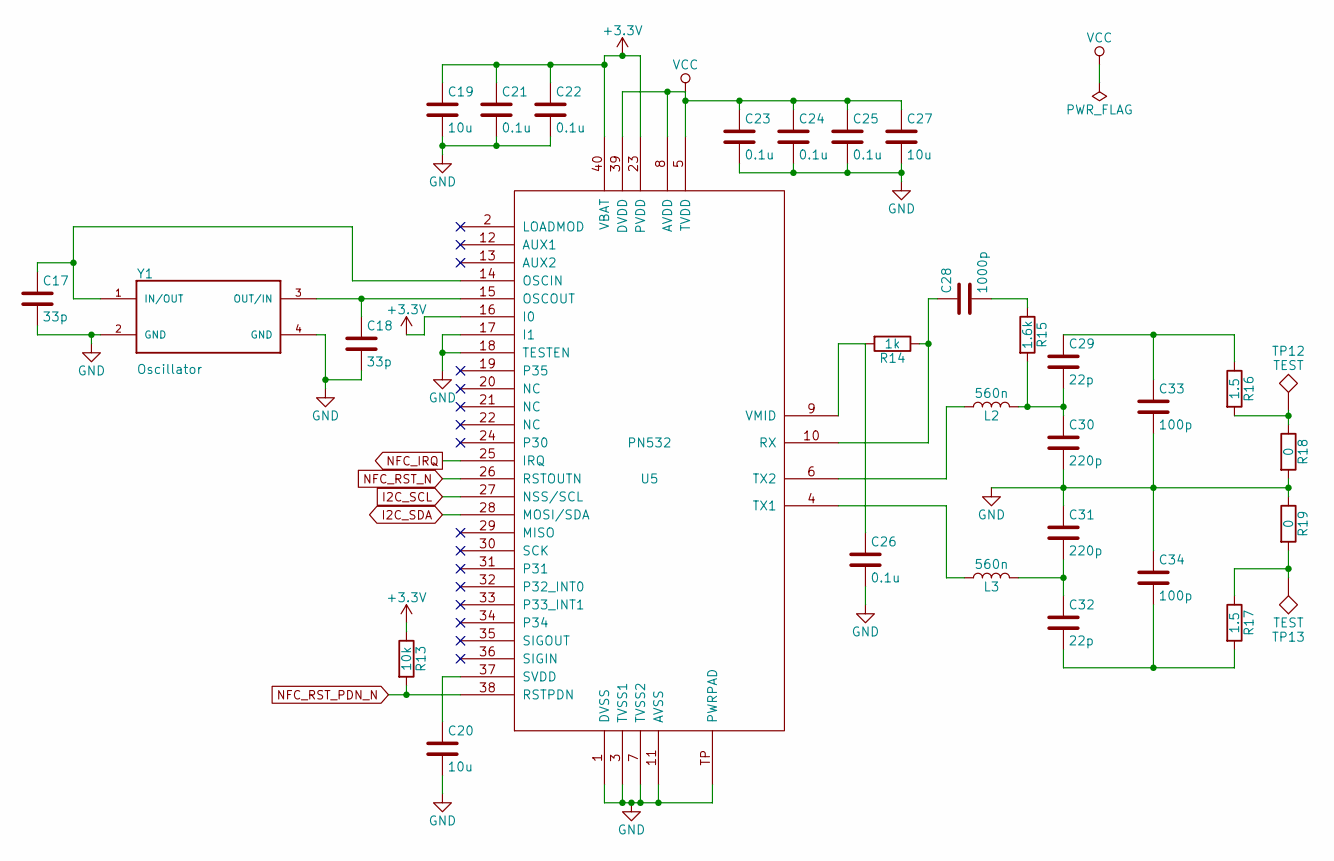
[picture p15: schematic NFC_Toy_NFC.sch]

Parts:
C17, C18: 33p; C_0402
C19, C20, C27: 10u; C_0603_HandSoldering
C21, C22, C23, C24, C25, C26: 0.1u; C_0402
C28: 1000p; C_0402
C29, C32: 22p; C_0402
C30, C31: 220p; C_0402
C33, C34: 100p; C_0402
L2, L3: 560n; L_0603_HandSoldering
R13: 10k; R_0603_HandSoldering
R14: 1k; R_0603_HandSoldering
R15: 1.6k; R_0603_HandSoldering
R16, R17: 1.5; R_0603_HandSoldering
R18, R19: 0; R_0402
TP12, TP13: TEST; Test_Point
U5: PN532; HVQFN40-6X6
Y1: Oscillator; OSCCC500X320X105N

Connections:
+3.3V: C19.1, C21.1, C22.1, R13.1, U5.16 (I0), U5.23 (PVDD), U5.40 (VBAT)
GND: C17.2, C18.2, C19.2, C20.2, C21.2, C22.2, C23.2, C24.2, C25.2, C26.2, C27.2, C30.2, C31.1, C33.2, C34.1, R18.2, R19.1, U5.1 (DVSS), U5.3 (TVSS1), U5.7 (TVSS2), U5.11 (AVSS), U5.17 (I1), U5.18 (TESTEN), U5.TP (PWRPAD), Y1.2 (GND), Y1.4 (GND)
I2C_SCL: U5.27 (NSS/SCL)
I2C_SDA: U5.28 (MOSI/SDA)
NFC_IRQ: U5.25 (IRQ)
NFC_RST_N: U5.26 (RSTOUTN)
NFC_RST_PDN_N: R13.2, U5.38 (RSTPDN)
unnamed: C17.1, U5.14 (OSCIN), Y1.1 (IN/OUT)
unnamed: C18.1, U5.15 (OSCOUT), Y1.3 (OUT/IN)
unnamed: C20.1, U5.37 (SVDD)
unnamed: C26.1, R14.2, U5.9 (VMID)
unnamed: C28.1, R14.1, U5.10 (RX)
unnamed: C28.2, R15.1
unnamed: C29.1, C33.1, R16.1
unnamed: C29.2, C30.1, L2.2, R15.2
unnamed: C31.2, C32.1, L3.2
unnamed: C32.2, C34.2, R17.2
unnamed: L2.1, U5.6 (TX2)
unnamed: L3.1, U5.4 (TX1)
unnamed: R16.2, R18.1, TP12.1
unnamed: R17.1, R19.2, TP13.1
VCC: C23.1, C24.1, C25.1, C27.1, U5.5 (TVDD), U5.8 (AVDD), U5.39 (DVDD)
