carrola1/NFC_Toy/Software/NFC_Toy/Src/main.cpp

/**
  ******************************************************************************
  * @file           : mainc
  * @brief          : Main program body
  ******************************************************************************
  * This notice applies to any and all portions of this file
  * that are not between comment pairs USER CODE BEGIN and
  * USER CODE END Other portions of this file, whether
  * inserted by the user or by software development tools
  * are owned by their respective copyright owners
  *
  * Copyright (c) 2018 STMicroelectronics International NV
  * All rights reserved
  *
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
  ******************************************************************************
  */
/* Includes ------------------------------------------------------------------*/
#include "main.h"
#include "stm32l0xx_hal.h"
#include "dma.h"
#include "diskio.h"
#include "ff.h"
#include "i2c.h"
#include "i2s.h"
#include "spi.h"
#include "gpio.h"
#include "rng.h"
#include "dotstar.hpp"
#include "ring_effects.hpp"
#include "lis3dh.hpp"
#include "wav_player.h"
#include "pn532.h"
#include "tag_ids.hpp"


/* USER CODE BEGIN PV */
FATFS FatFs;

// Loop timer
uint8_t loop_timer_flag = 0;
uint8_t loop_timer = 0;
uint16_t loop_period = 50; // 50ms loop

/* USER CODE END PV */

void SystemClock_Config(void);

/* USER CODE BEGIN PFP */
/* USER CODE END PFP */

/**
  * @brief  The application entry point
  *
  * @retval None
  */
int main(void)
{
  /* MCU Configuration----------------------------------------------------------*/

  /* Reset of all peripherals, Initializes the Flash interface and the Systick */
  HAL_Init();

  /* Configure the system clock */
  SystemClock_Config();

  /* Initialize all configured peripherals */
  MX_GPIO_Init();
  MX_DMA_Init();
  MX_I2C1_Init();
  MX_I2S2_Init();
  MX_SPI1_Init();
  MX_RNG_Init();
  /* USER CODE BEGIN 2 */

  // Setup accelerometer
  LIS3DH accel = LIS3DH();
  accel.begin(0x32);
  accel.writeRegister8(LIS3DH_REG_INT1CFG, 0x2A);
  accel.writeRegister8(LIS3DH_REG_INT1THS, 0xBF);
  accel.writeRegister8(LIS3DH_REG_INT1DUR, 0x30);
  accel.writeRegister8(LIS3DH_REG_CTRL3, 0x40);

  // Setup and initialize Dotstars
  DotStar ring = DotStar(16, DOTSTAR_RBG);
  ring.begin(); // Initialize pins for output
  RGB_VALS rgb_off;
  rgb_off.r = 0; rgb_off.g = 0; rgb_off.b = 0;
  ring_set_all_pixels(ring, rgb_off); // Initialize LEDs to off
  uint8_t brightness_all_on = 5;
  uint8_t brightness_ring = 20;

  // Mount SD Card
  FRESULT fr;     /* FatFs return code */
  HAL_GPIO_WritePin(SD_CS_GPIO_Port, SD_CS_Pin, GPIO_PIN_SET);
  fr = f_mount(&FatFs, "", 1);

  // Setup NFC Reader
  HAL_GPIO_WritePin(NFC_RST_PDN_N_GPIO_Port, NFC_RST_PDN_N_Pin, GPIO_PIN_SET);
  PN532 nfc = PN532();
  nfc.begin();
  nfc.SAMConfig();
  bool nfc_found;
  uint8_t uid[] = { 0, 0, 0, 0, 0, 0, 0 };  // Buffer to store the returned UID
  uint8_t uidLength;                        // Length of the UID (4 or 7 bytes depending on ISO14443A card type)
  tag detected_tag;
  tag tag_to_find;
  uint8_t randtagid;
  uint8_t nfc_search_timer = 0;
  uint8_t nfc_search_timeout = 5;

  // State Machine
  enum States { ST_request, ST_search, ST_response };
  States state = ST_request;
  /* USER CODE END 2 */

  /* Infinite loop */
  /* USER CODE BEGIN WHILE */
  // Task Scheduler
  while(1) {

    // State actions
    switch(state) {
      
      case ST_request:
        // Pick random tag
        randtagid = HAL_RNG_GetRandomNumber(&hrng) % num_tags;
        tag_to_find = tags[randtagid];
        // Turn on LEDs
        ring.setBrightness(brightness_all_on);
        ring_set_all_pixels(ring, tag_to_find.rgb);
        ring.setBrightness(brightness_ring);
        HAL_Delay(500);
        // Audio request
        play_wav(tag_to_find.wav_file_find);
        // Kick-off NFC reader
        nfc.readPassiveTargetID(PN532_MIFARE_ISO14443A, 10);
        nfc_search_timer = 0;
        state = ST_search;
        break;
      
      case ST_search:
        // Update LED ring on every pass
        ring.decrRing(tag_to_find.rgb);
        // Check if NFC found anything
        nfc_found = nfc.checkPassiveTargetStatus(uid, &uidLength);
        if (nfc_found) {
          detected_tag = find_tag(uid);
          state = ST_response;
        } else {
          // Re-ping NFC every once in a while
          if (nfc_search_timer == nfc_search_timeout) {
            nfc.readPassiveTargetID(PN532_MIFARE_ISO14443A, 10);
            nfc_search_timer = 0;
          } else {
            nfc_search_timer++;
          }
          state = ST_search;
        }
        break;

      case ST_response:
        ring.setBrightness(brightness_all_on);
        ring_set_all_pixels(ring, detected_tag.rgb);
        ring.setBrightness(brightness_ring);
        HAL_Delay(500);
        if (detected_tag.uid[0] == tag_to_find.uid[0]) {
          play_wav(detected_tag.wav_file_found);
        }
        play_wav(detected_tag.wav_file_color);
        ring_set_all_pixels(ring, rgb_off);
        HAL_Delay(500);
        state = ST_request;

      default:
        ST_request;
    }

    loop_timer_flag = 0;
    while (!loop_timer_flag) {
      // wait for timeout
    }

  }
  return 0;
  /* USER CODE END 3 */
}

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
/* USER CODE BEGIN 4 */
void HAL_SYSTICK_Callback(void) {
  if (loop_timer == loop_period) {
    loop_timer_flag = 1;
    loop_timer = 0;
  } else {
    loop_timer++;
  }
  return;
}

/* USER CODE END 4 */
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
