carrola1/NFC_Toy/Software/NFC_Toy_Dummy/NFC_Toy/Inc/main.h

#define AUDIO_SD_N_Pin GPIO_PIN_13
#define AUDIO_SD_N_GPIO_Port GPIOC
#define SD_DETECT_Pin GPIO_PIN_2
#define SD_DETECT_GPIO_Port GPIOA
#define SD_SW_Pin GPIO_PIN_3
#define SD_SW_GPIO_Port GPIOA
#define SD_CS_Pin GPIO_PIN_4
#define SD_CS_GPIO_Port GPIOA
#define DOT_STAR_DATA_Pin GPIO_PIN_0
#define DOT_STAR_DATA_GPIO_Port GPIOB
#define DOT_STAR_CLK_Pin GPIO_PIN_1
#define DOT_STAR_CLK_GPIO_Port GPIOB
#define LED_1_Pin GPIO_PIN_10
#define LED_1_GPIO_Port GPIOA
#define LED_2_Pin GPIO_PIN_11
#define LED_2_GPIO_Port GPIOA
#define XL_INT1_Pin GPIO_PIN_15
#define XL_INT1_GPIO_Port GPIOA
#define XL_INT1_EXTI_IRQn EXTI4_15_IRQn
#define XL_INT2_Pin GPIO_PIN_3
#define XL_INT2_GPIO_Port GPIOB
#define NFC_RST_PDN_N_Pin GPIO_PIN_4
#define NFC_RST_PDN_N_GPIO_Port GPIOB
#define NFC_RST_N_Pin GPIO_PIN_8
#define NFC_RST_N_GPIO_Port GPIOB
#define NFC_IRQ_Pin GPIO_PIN_9
#define NFC_IRQ_GPIO_Port GPIOB
