carrola1/NFC_Toy/(commit log)

2018-04-13 Ready to start layout
    [NFC Toy BOM.xlsx, NFC_Toy.sch, NFC_Toy_Audio.sch, NFC_Toy_DotStar.sch, NFC_Toy_NFC.sch]
2018-04-17 Layout started
    [NFC Toy BOM.xlsx, NFC_Toy.sch, NFC_Toy_Audio.sch, NFC_Toy_DotStar.sch, NFC_Toy_NFC.sch]
2018-04-23 Component placement complete.
    [Adafruit_PN532_Breakout_v1.4.brd, Adafruit_PN532_Breakout_v1.4.sch, NFC Toy BOM.xlsx, NFC_Toy.kicad_pcb, NFC_Toy.sch, NFC_Toy_Audio.sch, NFC_Toy_DotStar.sch, NFC_Toy_NFC.sch]
2018-04-25 Layout 75% complete
    [NFC_Toy.kicad_pcb, NFC_Toy.sch, NFC_Toy_NFC.sch]
2018-04-27 First pass layout complete
    [NFC Toy BOM.xlsx, NFC_Toy.kicad_pcb, NFC_Toy.sch]
2018-04-30 Preliminary layout complete
    [NFC_Toy-B.Cu.gbr, NFC_Toy-B.Paste.gbr, NFC_Toy-B.SilkS.gbr, NFC_Toy-Edge.Cuts.gbr, NFC_Toy-F.Cu.gbr, NFC_Toy-F.Paste.gbr, NFC_Toy-F.SilkS.gbr, NFC_Toy-NPTH.drl]
2018-05-02 Submitted to PCBWay for build
    [NFC Toy BOM.xlsx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]
2018-05-17 Added J-Link adapter and 1st cut of software
    [JLink_Adpater.kicad_pcb, JLink_Adpater.sch, NFC Toy BOM.xlsx, NFC_Toy.csv, NFC_Toy.xlsx]
2018-05-30 Added inverted JLink adapter. First working code.
    [JLink_Adpater.kicad_pcb, JLink_Adpater.sch, NFC_Toy.xlsx]
2018-06-04 Dotstar, accelerometer, audio working
2018-06-15 SD SPI interface working but getting FR_NOT_READY.
2018-06-29 Added PN532 library. Not sure it's working yet.
    Audio is playing correctly from buffer but there are long delays between each byte read from SD card. Causes long delays between writing out buffers to audio amp.
    [BlackBerry_App_Descriptor.xml]
2018-07-12 Audio appears to be working but only getting static
    Finally got I2S and SD card read timing working. Correct audio samples appear to be going out I2S and no I2S pauses between SD card reads.
    [NFC_Toy.ioc, main.cpp, wav_player.c]
2019-02-22 Added enclosure .stl
    [NFC Toy Base (old).stl, NFC Toy Base.stl]
2019-06-26 Added RNG and "Try Again"
    [NFC_Toy-2019-04-15-20-04-34.sch, NFC_Toy-2019-04-25-21-15-35.sch, NFC_Toy.sch, NFC_Toy_Audio-2019-04-15-20-04-34.sch, NFC_Toy_Audio-2019-04-25-21-15-35.sch, NFC_Toy_Audio.sch, NFC_Toy_DotStar-2019-04-15-20-04-34.sch, NFC_Toy_DotStar-2019-04-25-21-15-35.sch]
2020-01-07 Fixed audio distortion and migrated to STM32CUBEIDE
    Secret was to change GPIO speed of I2S signals from LOW to HIGH.
    [wav_player.c]
2020-01-08 LEDs now reflect color to be found.
2020-03-26 Changed to single state machine
    Task scheduler was interesting, but didn't make sense for this application. This single state machine is super simple and works great.
    [main.cpp]
