carrola1/NFC_Toy/(notices)

Notices in the files:
Software/NFC_Toy_Dummy/NFC_Toy/Inc/ffconf.h:
© Copyright (c) 2019 STMicroelectronics.
All rights reserved.
This software component is licensed by ST under Ultimate Liberty license
Software/NFC_Toy_Dummy/NFC_Toy/Inc/main.h:
(C) COPYRIGHT STMicroelectronics *****END OF FILE
Software/NFC_Toy/Inc/dotstar.hpp:
modify it under the terms of the GNU Lesser General Public License
